ThiagoRodriguez-yo/proyecto-MiniSumo-Sheer-heart-attack/Docs/3D-PCB.png

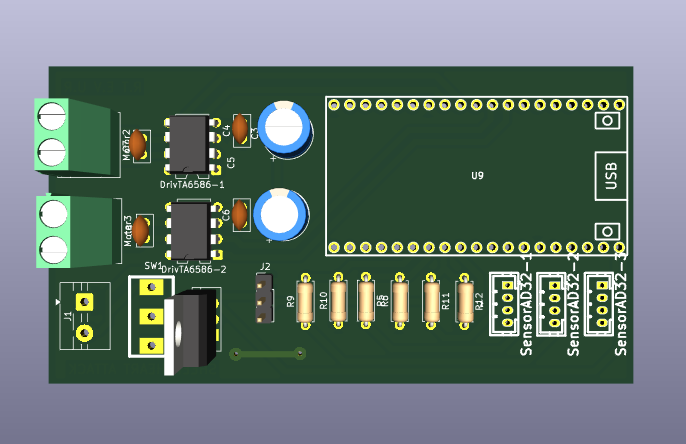
Docs/3D-PCB.png
