ThiagoRodriguez-yo/proyecto-MiniSumo-Sheer-heart-attack/Docs/3D-Robot.png

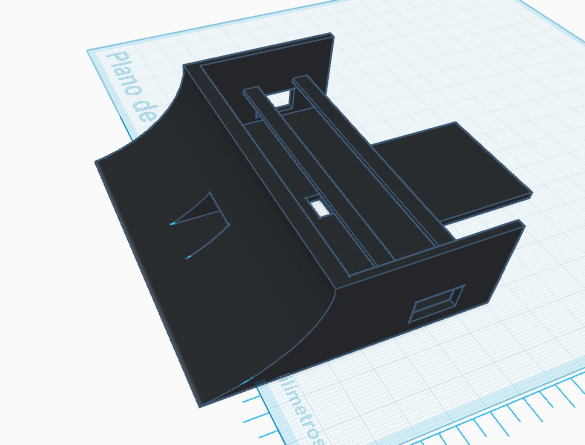
Docs/3D-Robot.png
