ThiagoRodriguez-yo/proyecto-MiniSumo-Sheer-heart-attack/Docs/Esquematico.png

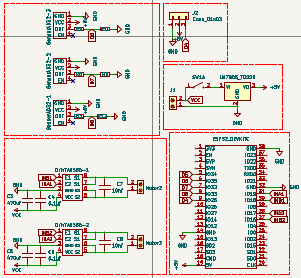
Docs/Esquematico.png
