ThiagoRodriguez-yo/proyecto-MiniSumo-Sheer-heart-attack/Docs/PCB.png

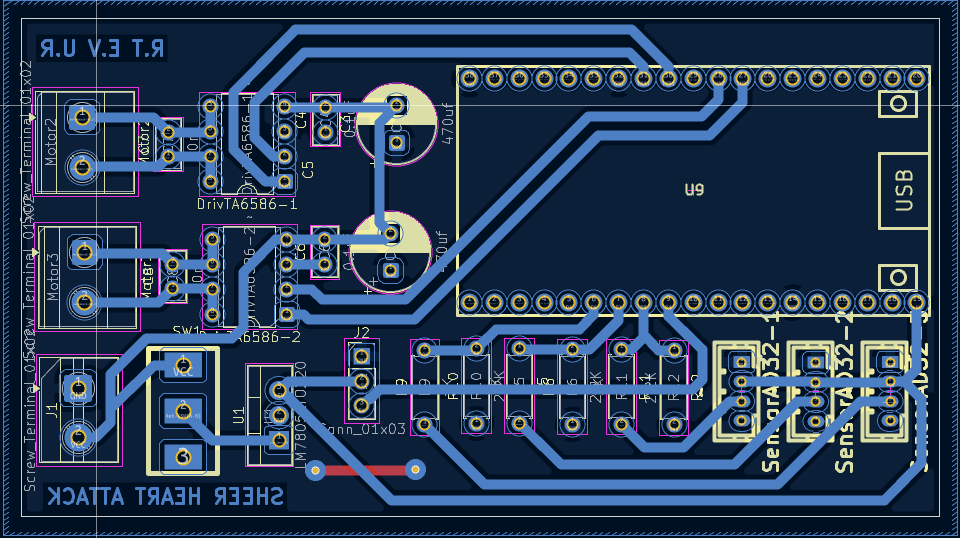
Docs/PCB.png
