ThiagoRodriguez-yo/proyecto-MiniSumo-Sheer-heart-attack/Kicad/mini sumo 2.kicad_pcb

## KiCad design Kicad/mini sumo 2.kicad_pcb (2025-11-27)

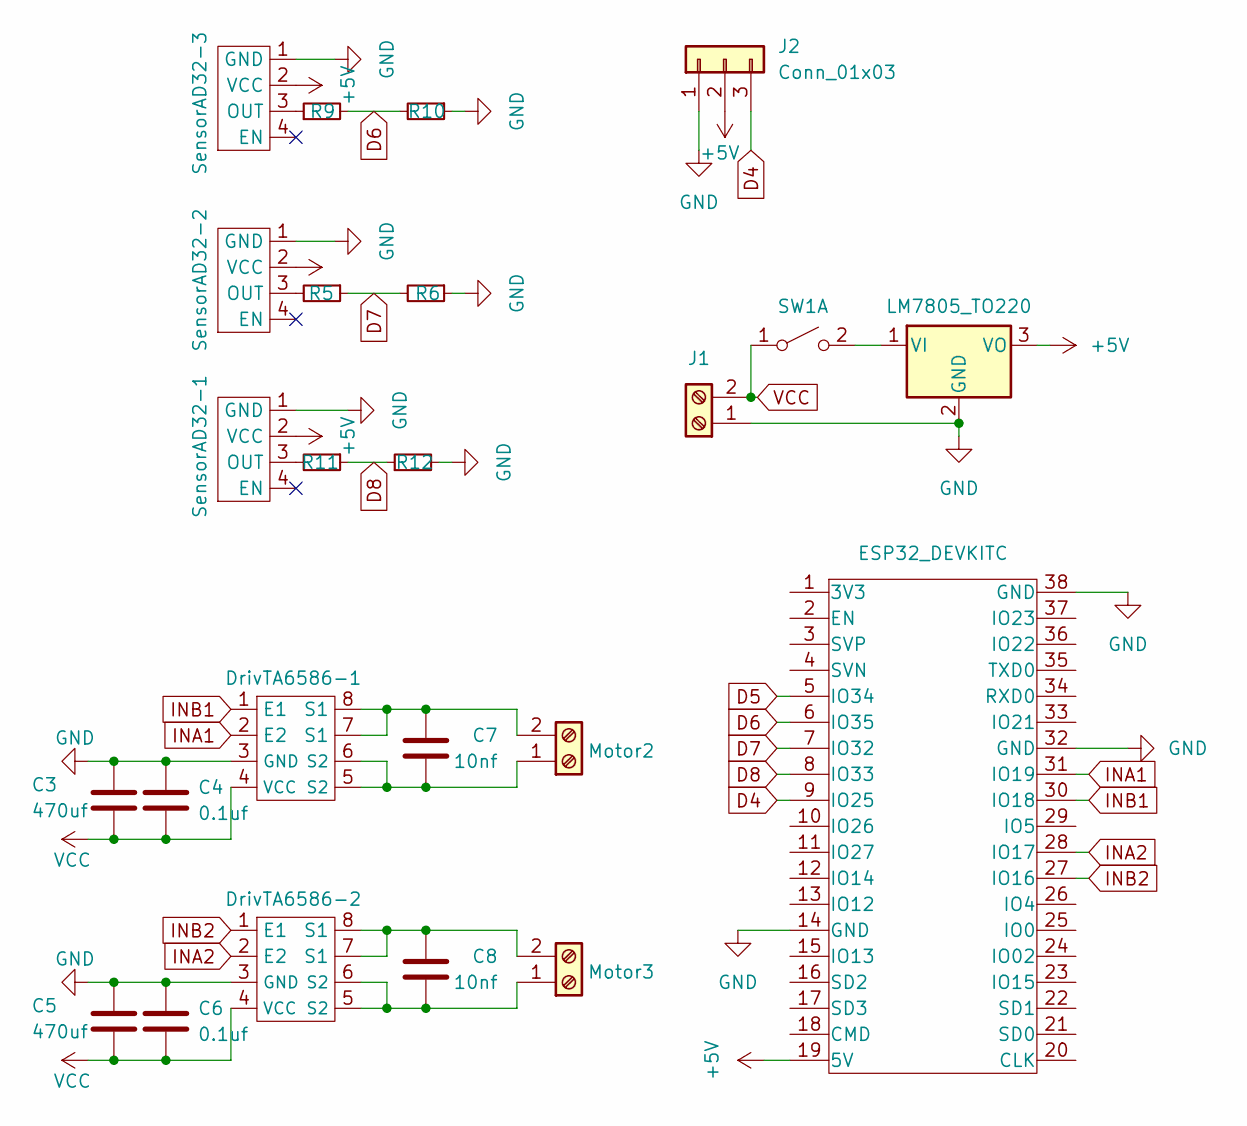
[picture p5: schematic mini sumo 2.kicad_sch]

Parts:
C3, C5: 470uf; CP_Radial_D8.0mm_P3.80mm
C4, C6: 0.1uf; C_Disc_D5.0mm_W2.5mm_P2.50mm
C7, C8: 10nf; C_Disc_D5.0mm_W2.5mm_P2.50mm
DrivTA6586-1, DrivTA6586-2: DIP-8_W7.62mm
J1: Screw_Terminal_01x02; TerminalBlock_MaiXu_MX126-5.0-02P_1x02_P5.00mm
J2: Conn_01x03; PinHeader_1x03_P2.54mm_Vertical
Motor2, Motor3: Screw_Terminal_01x02; TerminalBlock_Phoenix_MKDS-1,5-2-5.08_1x02_P5.08mm_Horizont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
R5, R9, R11: 1K; R_Axial_DIN0207_L6.3mm_D2.5mm_P7.62mm_Horizontal
R6, R10, R12: 2.2K; R_Axial_DIN0207_L6.3mm_D2.5mm_P7.62mm_Horizontal
SW1: SW_DPST_x2; SW_SPDT_TH_Vertical
SensorAD32-1, SensorAD32-2, SensorAD32-3: JST-4V
U1: LM7805_TO220; TO-220-3_Vertical
U9: ESP32_DEVKITC; ESP32S

Connections:
+5V: J2.2, SensorAD32-1.2 (VCC), SensorAD32-2.2 (VCC), SensorAD32-3.2 (VCC), U1.3 (VO), U9.19 (5V)
D4: J2.3, U9.9 (IO25)
D5: U9.5 (IO34)
D6: R9.2, R10.2, U9.6 (IO35)
D7: R5.1, R6.2, U9.7 (IO32)
D8: R11.1, R12.1, U9.8 (IO33)
GND: C3.1, C4.1, C5.1, C6.1, DrivTA6586-1.3 (GND), DrivTA6586-2.3 (GND), J1.1, J2.1, R6.1, R10.1, R12.2, SensorAD32-1.1 (GND), SensorAD32-2.1 (GND), SensorAD32-3.1 (GND), U1.2 (GND), U9.14 (GND), U9.32 (GND), U9.38 (GND)
INA1: DrivTA6586-1.2 (E2), U9.31 (IO19)
INA2: DrivTA6586-2.2 (E2), U9.28 (IO17)
INB1: DrivTA6586-1.1 (E1), U9.30 (IO18)
INB2: DrivTA6586-2.1 (E1), U9.27 (IO16)
unnamed: C7.2, DrivTA6586-1.5 (S2), DrivTA6586-1.6 (S2), Motor2.1
unnamed: C7.1, DrivTA6586-1.7 (S1), DrivTA6586-1.8 (S1), Motor2.2
unnamed: C8.2, DrivTA6586-2.5 (S2), DrivTA6586-2.6 (S2), Motor3.1
unnamed: C8.1, DrivTA6586-2.7 (S1), DrivTA6586-2.8 (S1), Motor3.2
unnamed: SW1.2 (B), U1.1 (VI)
unnamed: R11.2, SensorAD32-1.3 (OUT)
unnamed: R5.2, SensorAD32-2.3 (OUT)
unnamed: R9.1, SensorAD32-3.3 (OUT)
VCC: C3.2, C4.2, C5.2, C6.2, DrivTA6586-1.4 (VCC), DrivTA6586-2.4 (VCC), J1.2, SW1.1 (A)

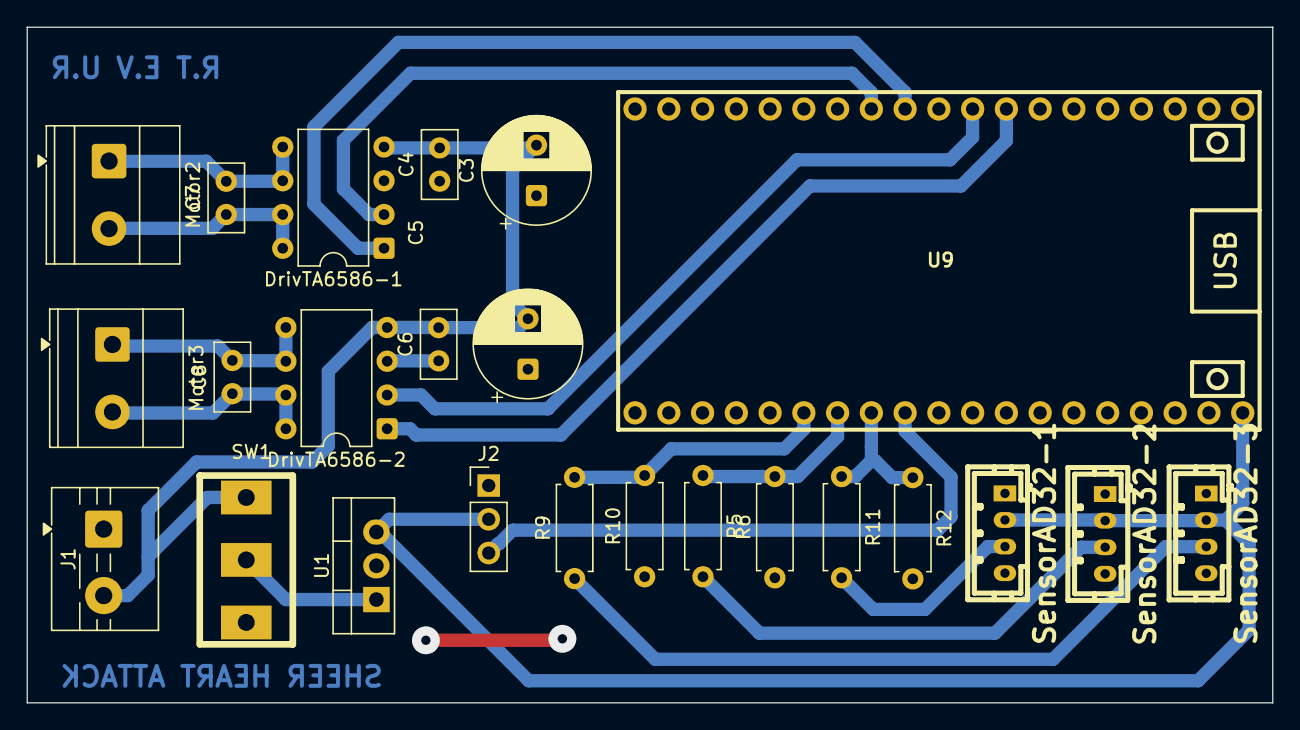
[picture p6: board mini sumo 2.kicad_pcb from above]

Board: 2 copper layers, 93.7 x 50.8 mm, 24 parts (0 on the bottom side), 19 nets.
