ThiagoRodriguez-yo/proyecto-MiniSumo-Sheer-heart-attack/(commit log)

2025-11-27 Rename Captura de pantalla 2025-10-30 084429.png to Esquematico.png
2025-11-27 Rename Captura de pantalla 2025-11-27 102052.png to 3D-Robot.png
2025-11-27 Rename Captura de pantalla 2025-10-30 084342.png to PCB.png
2025-11-27 Rename Captura de pantalla 2025-11-27 101918.png to 3D-PCB.png
